teixeluis/camera_shutter_timer/diagrams/CameraShutterTimer.sch

## KiCad design diagrams/CameraShutterTimer.sch (2019-06-23)

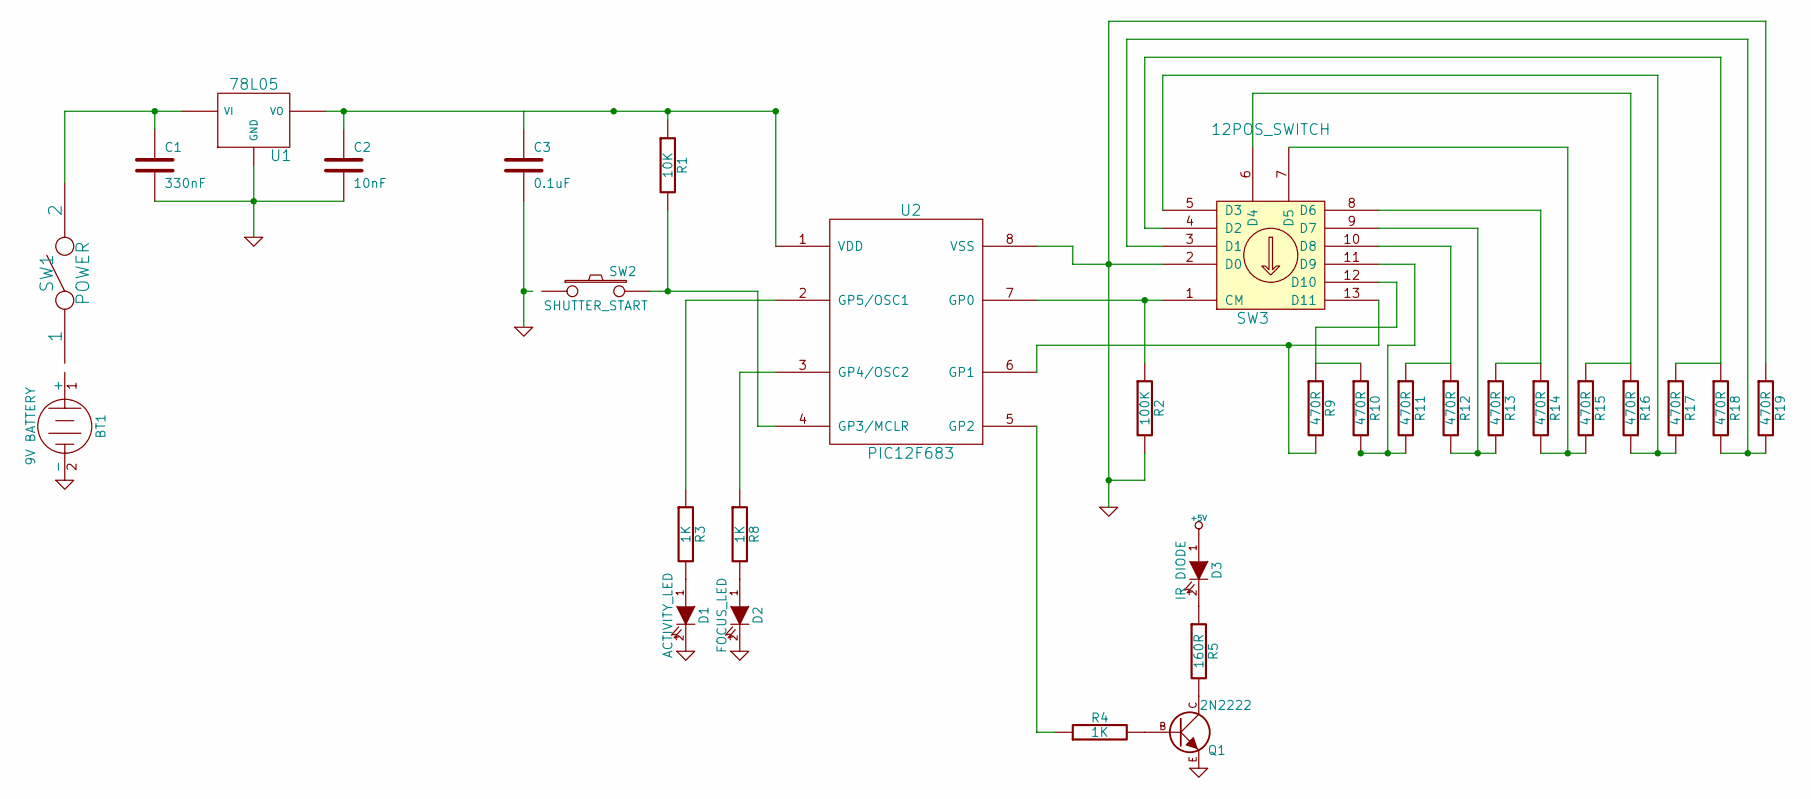
[picture p5: schematic CameraShutterTimer.sch]

Parts:
BT1: 9V BATTERY
C1: 330nF
C2: 10nF
C3: 0.1uF
D1: ACTIVITY_LED
D2: FOCUS_LED
D3: IR DIODE
Q1: 2N2222; TO92-EBC
R1: 10K
R2: 100K
R3, R4, R8: 1K
R5: 160R
R9, R10, R11, R12, R13, R14, R15, R16, R17, R18, R19: 470R
SW1: POWER
SW2: SHUTTER_START
SW3: 12POS_SWITCH
U1: 78L05
U2: PIC12F683

Connections:
+5V: D3.1 (A)
GND: BT1.2 (-), C1.2, C2.2, C3.2, D1.2 (K), D2.2 (K), Q1.E, R2.2, R19.1, SW3.2 (D0), U1.GND, U2.8 (VSS)
unnamed: C1.1, SW1.2, U1.VI
unnamed: C2.1, R1.1, U1.VO, U2.1 (VDD)
unnamed: D1.1 (A), R3.2
unnamed: D2.1 (A), R8.2
unnamed: D3.2 (K), R5.1
unnamed: Q1.B, R4.2
unnamed: Q1.C, R5.2
unnamed: R1.2, SW2.2, U2.4 (GP3/MCLR)
unnamed: R2.1, SW3.1 (CM), U2.7 (GP0)
unnamed: R3.1, U2.2 (GP5/OSC1)
unnamed: R4.1, U2.5 (GP2)
unnamed: R8.1, U2.3 (GP4/OSC2)
unnamed: R9.2, SW3.13 (D11), U2.6 (GP1)
unnamed: R9.1, R10.1, SW3.12 (D10)
unnamed: R10.2, R11.2, SW3.11 (D9)
unnamed: R11.1, R12.1, SW3.10 (D8)
unnamed: R12.2, R13.2, SW3.9 (D7)
unnamed: R13.1, R14.1, SW3.8 (D6)
unnamed: R14.2, R15.2, SW3.7 (D5)
unnamed: R15.1, R16.1, SW3.6 (D4)
unnamed: R16.2, R17.2, SW3.5 (D3)
unnamed: R17.1, R18.1, SW3.4 (D2)
unnamed: R18.2, R19.2, SW3.3 (D1)
