teixeluis/camera_shutter_timer/(commit log)

2019-06-23 Initial commit based on repo initially in:
    https://sourceforge.net/projects/camerashuttertimer/
    [CameraShutterTimer.sch]
2019-06-23 Added schematic to the document.
